carpman/OSHWatch/Hardware/OSHWatch.kicad_pcb

## KiCad design Hardware/OSHWatch.kicad_pcb (2015-07-09)

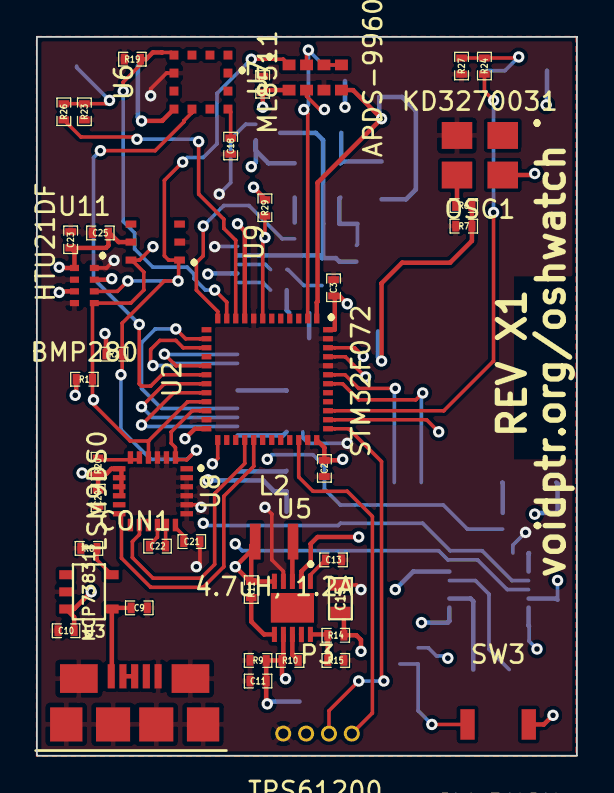
[picture p1: board OSHWatch.kicad_pcb from above]

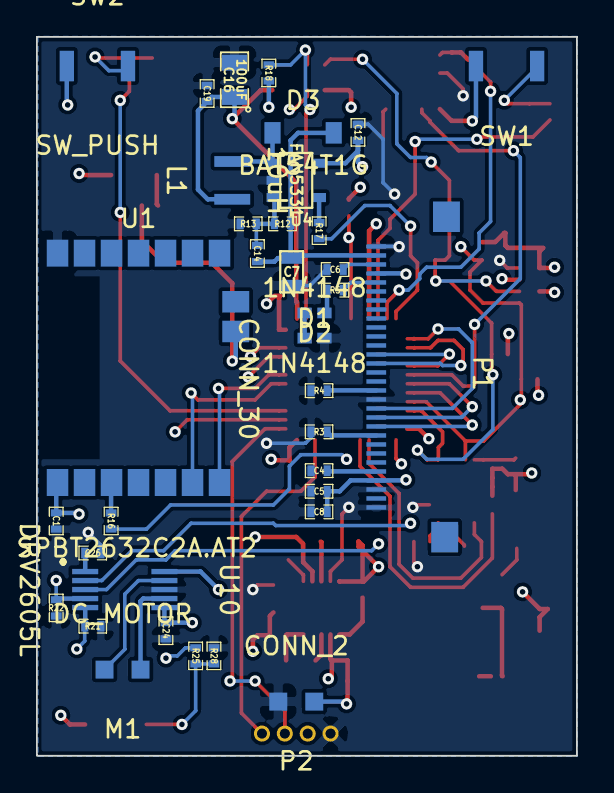
[picture p2: board OSHWatch.kicad_pcb from below]

Board: 4 copper layers, 30.0 x 39.9 mm, 80 parts (36 on the bottom side), 61 nets.

Parts:
C1, C2, C5, C8, C9, C10, C11, C20: 10uF; SM0402
C3: 100pF; SM0402
C4, C6, C26: 1uF; SM0402
C7: 10uF,16V; SM0603
C12: 10uF,6.3V; SM0402
C13, C24: 0.1uF; SM0402
C14: 0.1uF,16V; SM0402
C15: 22uF; SM0603
C16: 100uF; SM0805
C17, C19: 1uf; SM0402
C18: 1nF; SM0402
C21: 4.7uF; SM0402
C22: .22uF; SM0402
C23, C25: 100nF; SM0402
CON1: USB-MINI-B; 10118192
D1, D2: 1N4148; SOD-523
D3: BAT54T1G; SOD-123
L1: 10uH; 2518
L2: 4.7uH, 1.2A; 2518
M1: DC_MOTOR; 2PAD
OSC1: KD3270031
P1: CONN_30; XF2M-3015-1A
P2: CONN_2; 2PAD
P3: CONN_4; 4pin
R1, R2: 4.7K; SM0402
R3: 600K; SM0402
R4, R6, R7, R13, R16, R17, R18, R20, R23, R24, R25, R26, R27, R28, R29: 10K; SM0402
R5: 50; SM0402
R8: 2K; SM0402
R9, R15: 220K; SM0402
R10, R11: 10k; SM0402
R12: 100K; SM0402
R14: 1.2M; SM0402
R19, R21, R22: 200k; SM0402
SW1, SW2, SW3: SW_PUSH; B3U-3000P
U1: SPBT2632C2A.AT2; SPBT2632C2A
U2: STM32F072; UFQFPN48
U3: MCP73831T; SOT23-5
U4: FAN5331; SOT23-5
U5: TPS61200; VSON-10
U6: ML8511
U7: APDS-9960
U8: LSM9DS0
U9: HTU21DF; HTU12DF
U10: DRV2605L; VSSOP-10
U11: BMP280

Connections:
+3.3V: C1.1, C2.1, C3.1, C5.2, C8.2, C15.1, C17.1, C20.1, C23.1, C25.1, OSC1.4, P1.4, P1.27, R1.1, R2.1, R14.1, R18.2, R20.2, R29.1, SW1.2, SW2.1, SW3.2, U1.8, U2.9, U2.24, U2.36, U2.48, U5.2, U6.7, U7.8, U8.15, U8.16, U8.17, U8.18, U9.5, U11.2, U11.6, U11.8
+5V: C9.1, CON1.1, U3.4
+12V: C7.2, C14.1, D3.2, P1.2, R12.1
+BATT: C10.1, C11.1, C12.1, C16.1, C19.1, C24.1, L1.1, L2.1, P2.1, R9.1, R10.1, R11.1, U2.1, U3.3, U4.5, U5.5, U5.7, U7.5, U10.6, U10.10
/Bluetooth/32KHZ_CLK: OSC1.3, R6.2
/Bluetooth/BT_RESET: R16.2, U2.25
/Bluetooth/BT_RX_STM_TX: U1.13, U2.42
/Bluetooth/BT_TX_STM_RX: U1.14, U2.43
/Display/DISPLAY_CS: P1.19, U2.14
/Display/DISPLAY_DC: P1.20, U2.19
/Display/DISPLAY_MOSI: P1.13, U2.17
/Display/DISPLAY_RESET: P1.21, U2.20
/Display/DISPLAY_SCK: P1.14, U2.15
/Power/DISPLAY_BIAS_EN: R17.1, U2.12
/STM32F072/BUTTON_1: R26.2, U2.10
/STM32F072/BUTTON_2: R24.2, U2.39
/STM32F072/BUTTON_3: R25.2, U2.38
/STM32F072/GESTURE_INT: R18.1, U2.2, U7.2
/STM32F072/GYRO_INT: U2.28, U8.11
/STM32F072/I2C_SCK: R1.2, U2.21, U7.7, U8.21, U9.6, U10.2, U11.4
/STM32F072/I2C_SDA: R2.2, U2.22, U7.1, U8.24, U9.1, U10.3, U11.3
/STM32F072/NRST: P3.2, R29.2, U2.7
/STM32F072/UV_EN: R19.2, U2.11, U6.4
/STM32F072/UV_OUT: U2.18, U6.8
/STM32F072/VIB_EN: R21.2, U2.45, U10.5
/STM32F072/VIB_TRIG: R22.2, U2.46, U10.4
/STM32F072/XM_INT: U2.29, U8.13
GND: C1.2, C2.2, C3.2, C4.1, C5.1, C6.1, C7.1, C8.1, C9.2, C10.2, C11.2, C12.2, C13.2, C15.2, C16.2, C17.2, C18.2, C19.2, C20.2, C21.2, C23.2, C24.2, C25.2, C26.1, CON1.5, CON1.6, CON1.7, CON1.8, CON1.9, D1.2, OSC1.2, P1.1, P1.18, P1.28, P1.30, P2.2, P3.1, R3.1, R4.1, R7.2, R8.2, R9.2, R13.2, R15.2, R19.1, R21.1, R22.1, R23.1, R27.2, R28.2, U1.7, U2.8, U2.23, U2.35, U2.44, U2.47, U3.2, U4.2, U5.4, U5.9, U6.5, U7.6, U8.2, U8.3, U8.4, U8.5, U8.6, U8.22, U8.23, U9.2, U10.8, U11.1, U11.5, U11.7
unnamed: R16.1, U1.10
unnamed: R6.1, R7.1, U1.15
unnamed: P3.4, U2.34
unnamed: P3.3, U2.37
unnamed: P1.17, R4.2
unnamed: D1.1, D2.2
unnamed: D2.1, R5.1
unnamed: P1.5, R5.2
unnamed: C4.2, P1.26
unnamed: P1.22, R3.2
unnamed: C6.2, P1.3
unnamed: D3.1, L1.2, U4.1
unnamed: R8.1, U3.5
unnamed: R10.2, U5.8
unnamed: CON1.2, CON1.3
unnamed: C14.2, R12.2, R13.1, U4.3
unnamed: R17.2, U4.4
unnamed: R14.2, R15.1, U5.10
unnamed: C13.1, U5.1
unnamed: L2.2, U5.3
unnamed: R11.2, U5.6
unnamed: M1.2, U10.9
unnamed: M1.1, U10.7
unnamed: C18.1, U6.10
unnamed: R20.1, U8.19, U8.20
unnamed: C26.2, U10.1
unnamed: R24.1, R27.1, SW2.2
unnamed: R25.1, R28.1, SW3.1
unnamed: R23.2, R26.1, SW1.1
unnamed: C21.1, U8.7
unnamed: C22.1, U8.8
unnamed: U7.3, U7.4
unnamed: C22.2, U8.9
