carpman/OSHWatch/(commit log)

2015-06-08 Move uart functions to hal, clean up some warnings
2015-06-14 Start the hardware design
    [OSHWatch.sch]
2015-06-14 Begin on the schematic and footprints
    [OSHWatch.sch, OSHWatch_BT.sch, OSHWatch_Display.sch, OSHWatch_Power.sch, OSHWatch_STM.sch, OSHWatch_Sensors.sch]
2015-06-15 Adding sensors
    [OSHWatch.sch, OSHWatch_BT.sch, OSHWatch_Display.sch, OSHWatch_Power.sch, OSHWatch_STM.sch, OSHWatch_Sensors.sch]
2015-06-23 Powering directly from battery won't work due to needing to run duing a charge cycle. Added 3.3v regulator, battery management, resistor divider for sensing battery voltage.
    [OSHWatch.sch, OSHWatch_BT.sch, OSHWatch_Display.sch, OSHWatch_Power.sch, OSHWatch_STM.sch, OSHWatch_Sensors.sch]
2015-06-23 Connect sense line to STM32
    [OSHWatch.sch, OSHWatch_STM.sch]
2015-06-25 Working on display bias dc-to-dc
    [OSHWatch.sch, OSHWatch_BT.sch, OSHWatch_Display.sch, OSHWatch_Power.sch, OSHWatch_STM.sch, OSHWatch_Sensors.sch]
2015-06-29 Nearly completed schematic
    [OSHWatch.sch, OSHWatch_BT.sch, OSHWatch_Display.sch, OSHWatch_Power.sch, OSHWatch_STM.sch, OSHWatch_Sensors.sch]
2015-07-02 More packages, including schematic
    [OSHWatch.kicad_pcb, OSHWatch.sch, OSHWatch_BT.sch, OSHWatch_Display.sch, OSHWatch_Power.sch, OSHWatch_STM.sch, OSHWatch_Sensors.sch]
2015-07-05 Initial layout complete
    [OSHWatch.kicad_pcb, OSHWatch.sch, OSHWatch_BT.sch, OSHWatch_Display.sch, OSHWatch_Power.sch, OSHWatch_STM.sch, OSHWatch_Sensors.sch]
2015-07-07 Footprint corrections
    [OSHWatch.kicad_pcb]
2015-07-08 Final footprint corrections, gerbers
    [OSHWatch-B_Cu.gbl, OSHWatch-B_SilkS.gbo, OSHWatch-Edge_Cuts.gbr, OSHWatch-F_Cu.gtl, OSHWatch-F_SilkS.gto, OSHWatch-Inner1_Cu.gbr, OSHWatch-Inner2_Cu.gbr, OSHWatch.drl]
2015-07-09 Rev X1 Gerbers
    [OSHWatch-B_Cu.gbl, OSHWatch-B_Mask.gbs, OSHWatch-B_SilkS.gbo, OSHWatch-Edge_Cuts.gbr, OSHWatch-F_Cu.gtl, OSHWatch-F_Mask.gts, OSHWatch-F_SilkS.gto, OSHWatch-Inner1_Cu.gbr]
